GAGER41/oximetre/ampli-op.png

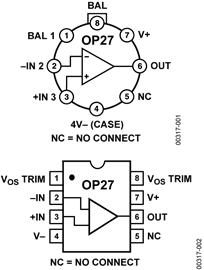
ampli-op.png
