GAGER41/oximetre/pouls.png

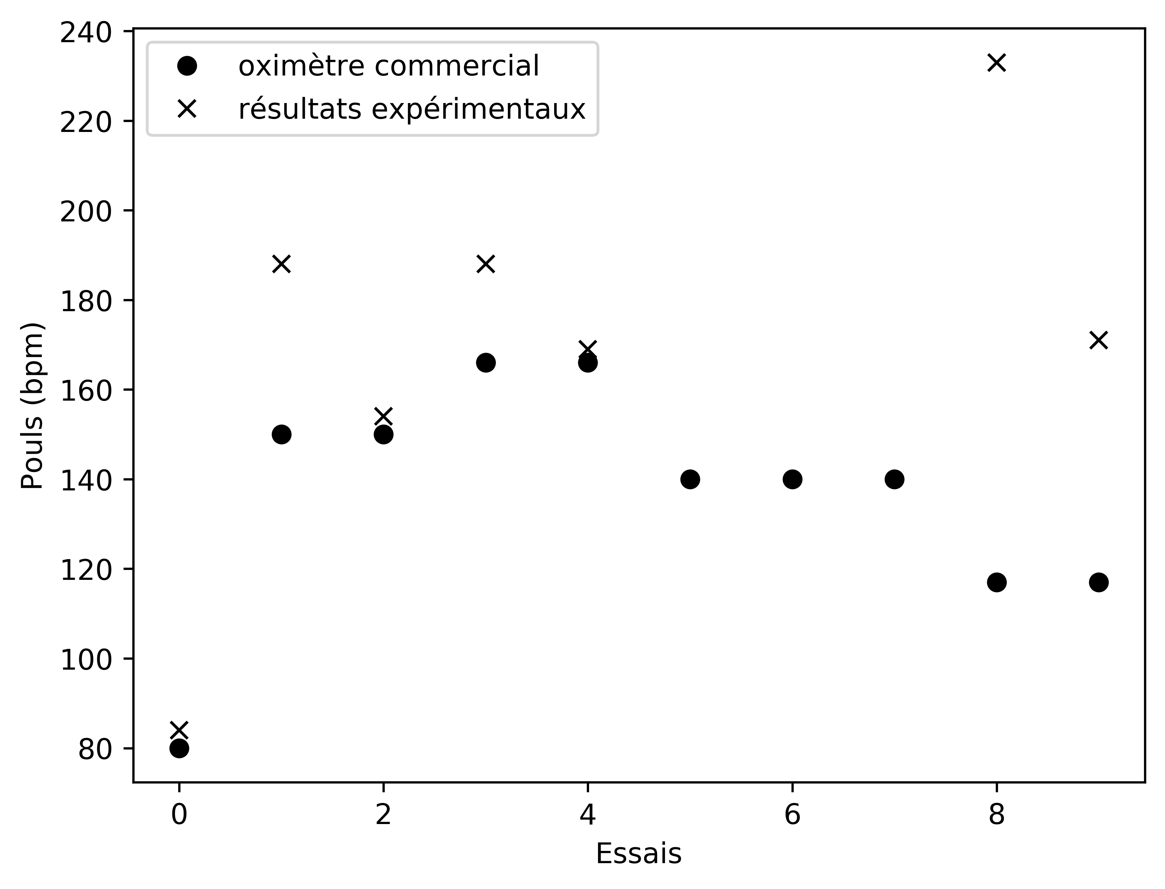
pouls.png
