GAGER41/oximetre/taux.png

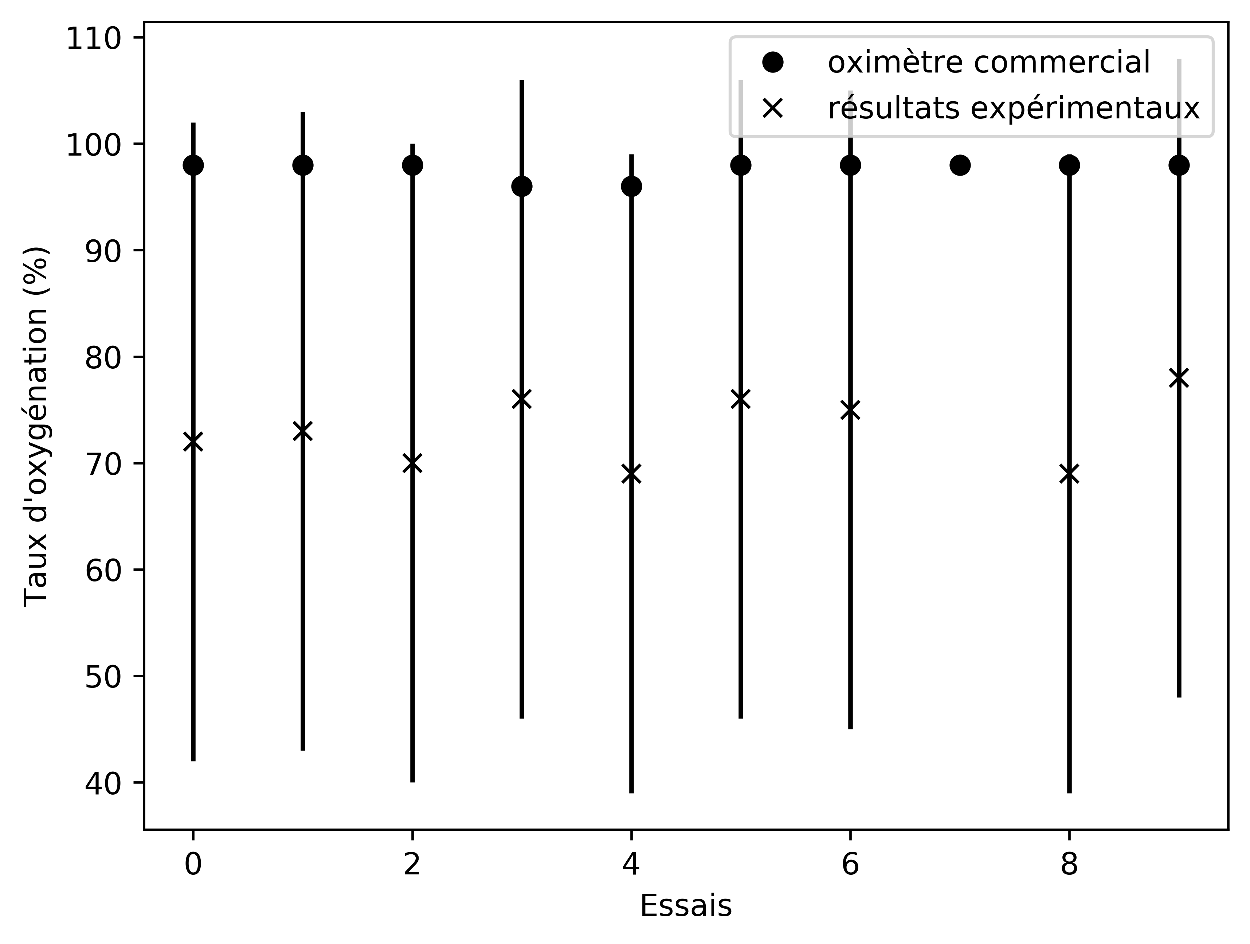
taux.png
