GAGER41/oximetre/transistor.jpg

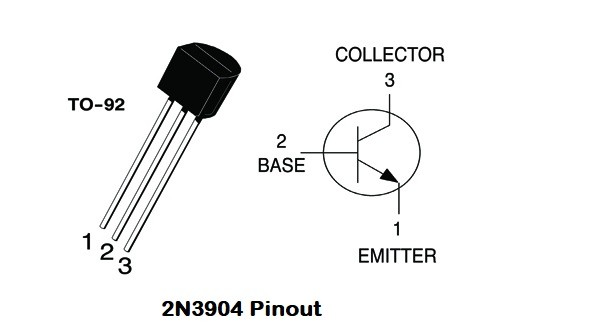
transistor.jpg
